scadam526/audio_amp_main_board/README.md

# audio_amp_main_board
Main board for a stereo 60W-per-channel amp. Includes four RCA analog L/R inputs, pre-amp input switching and volume control, main gain stage and output protection and muting.
