scadam526/audio_amp_main_board/(threads)

Thread 3 (2020-01-24):

Part placement

scadam526, 2020-01-24:
Place parts in their general location. Routing to be finalized once BOM review is complete.

scadam526, 2020-01-30:
Auto-route showed that 4-layer is much preferred. Created 4-layer board branch to try it out. 4-layer offers ability to route main audio and power traces as desired then easily auto-route the remainder around it. Still will not have +/-35V power planes. They power (dc and audio) will still be routed as 2mm traces and all layers will get GND fill planes.

Closed 2020-04-08.
