scadam526/audio_amp_main_board/doc/Printing Print Schematic.pdf

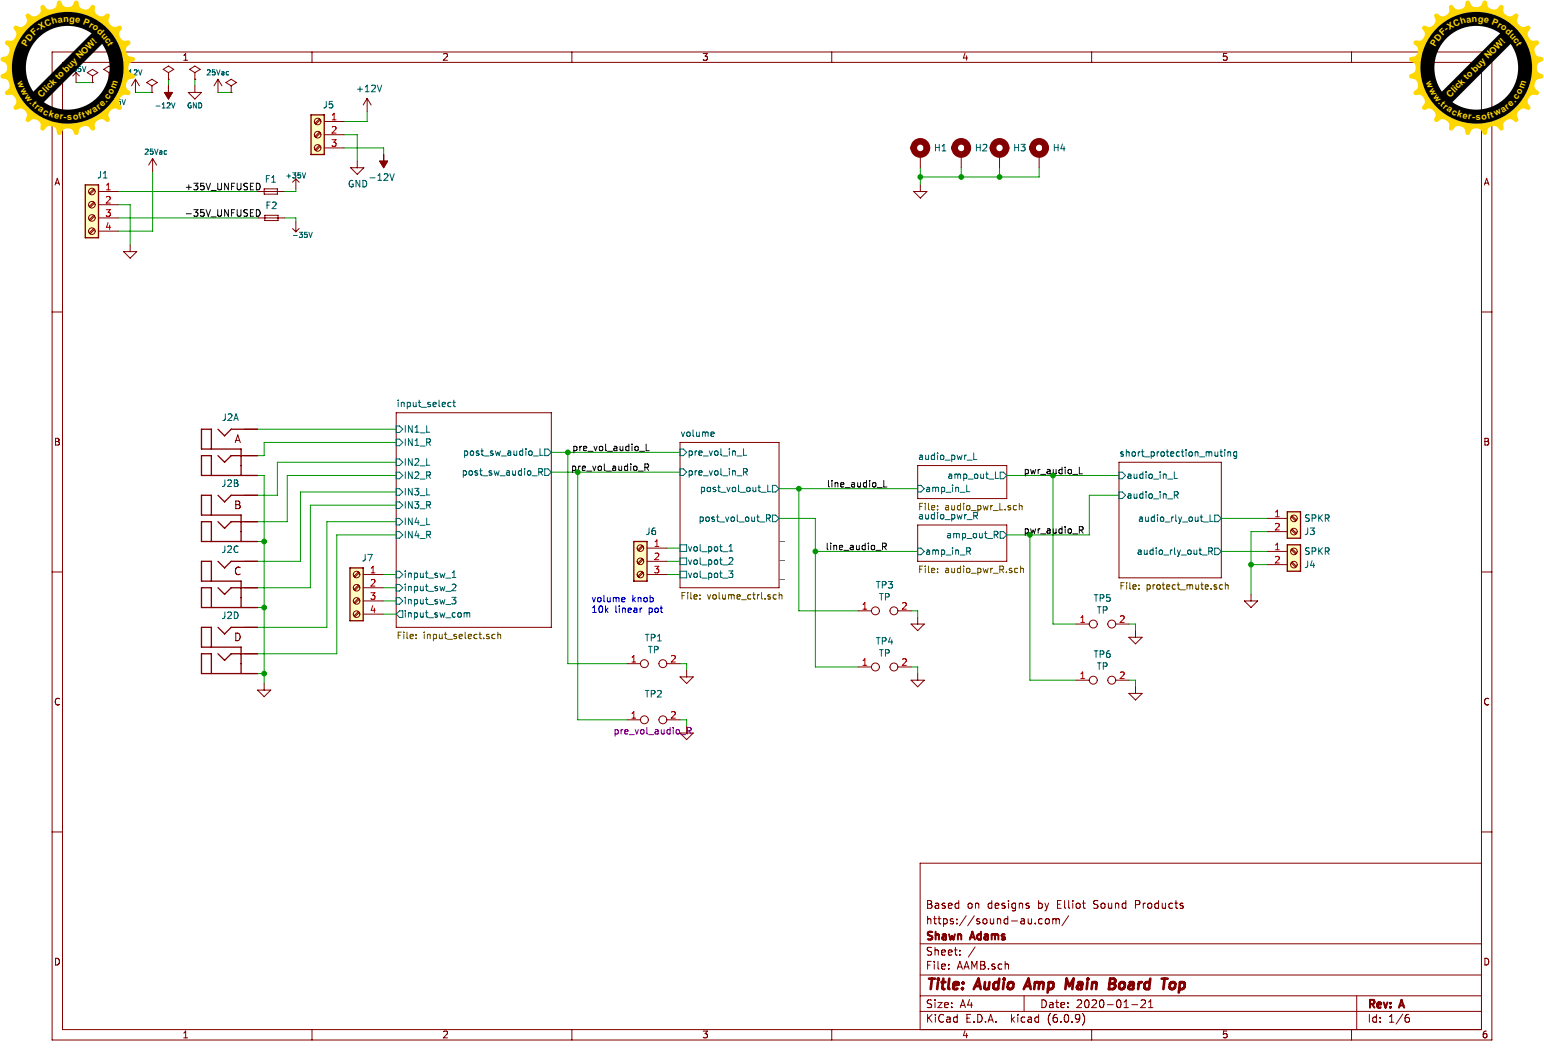
[picture p1: page 1]

PDF-XChange Product

Click to buy NOW!

www.tracker-software.com

www.tracker-software.com (http://www.tracker-software.com/buy-now)

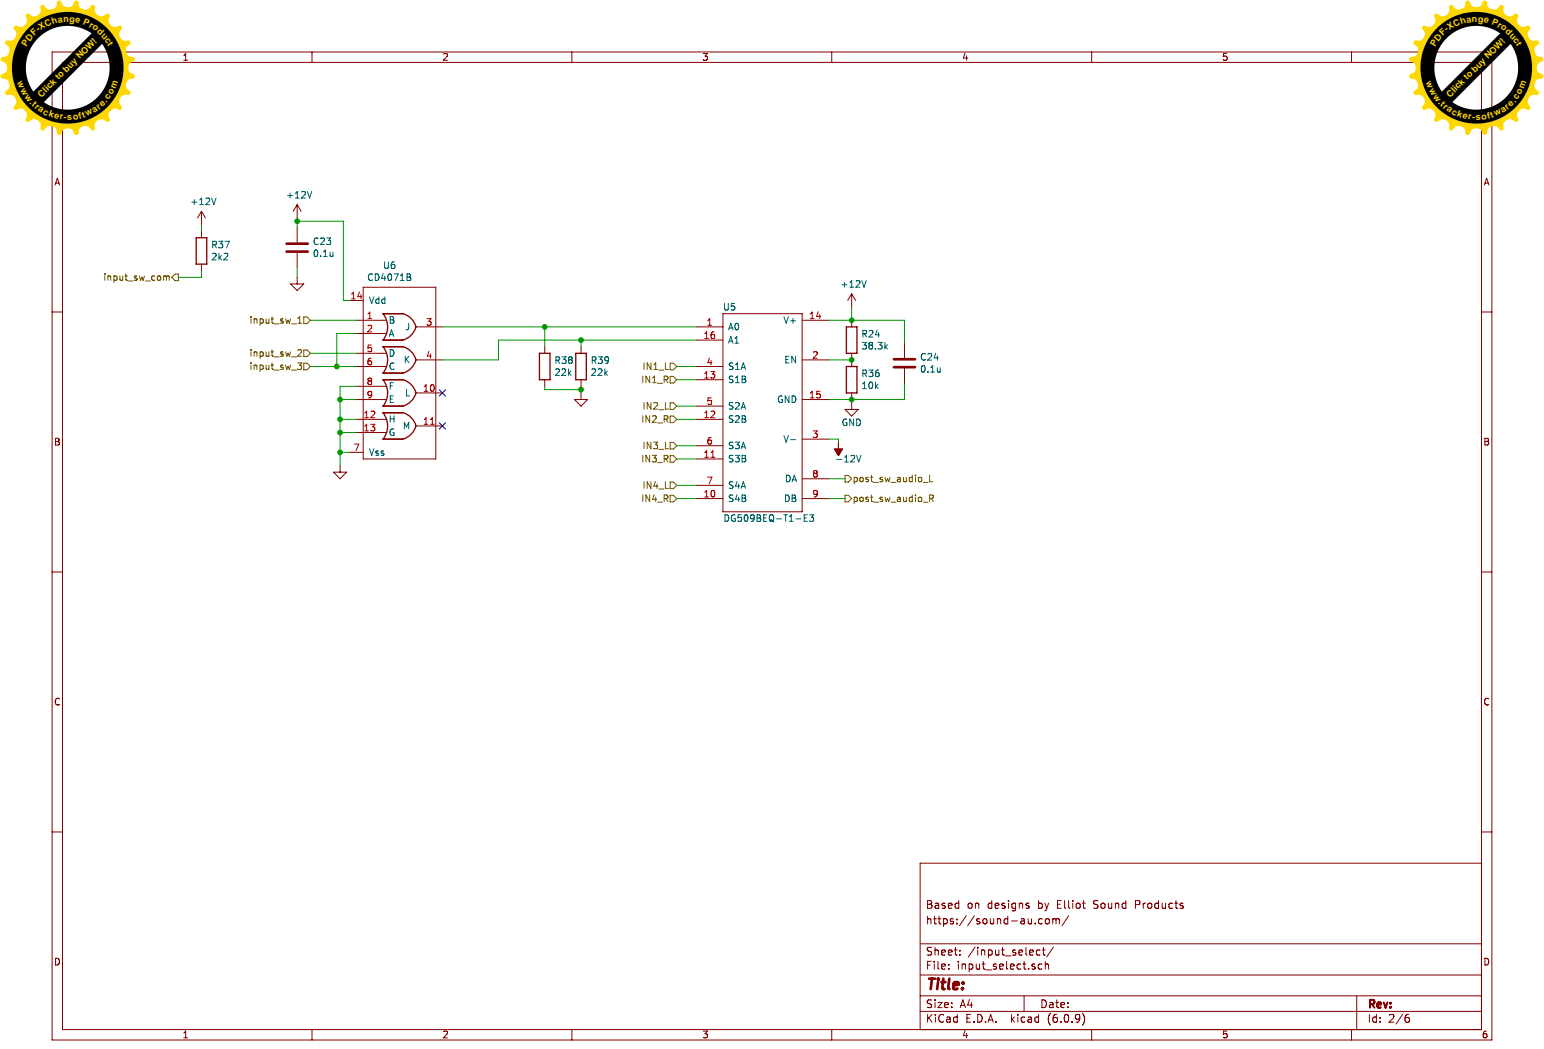
[picture p2: page 2]

Click to buy NOW!

www.tracker-software.com

www.tracker-software.com (http://www.tracker-software.com/buy-now)

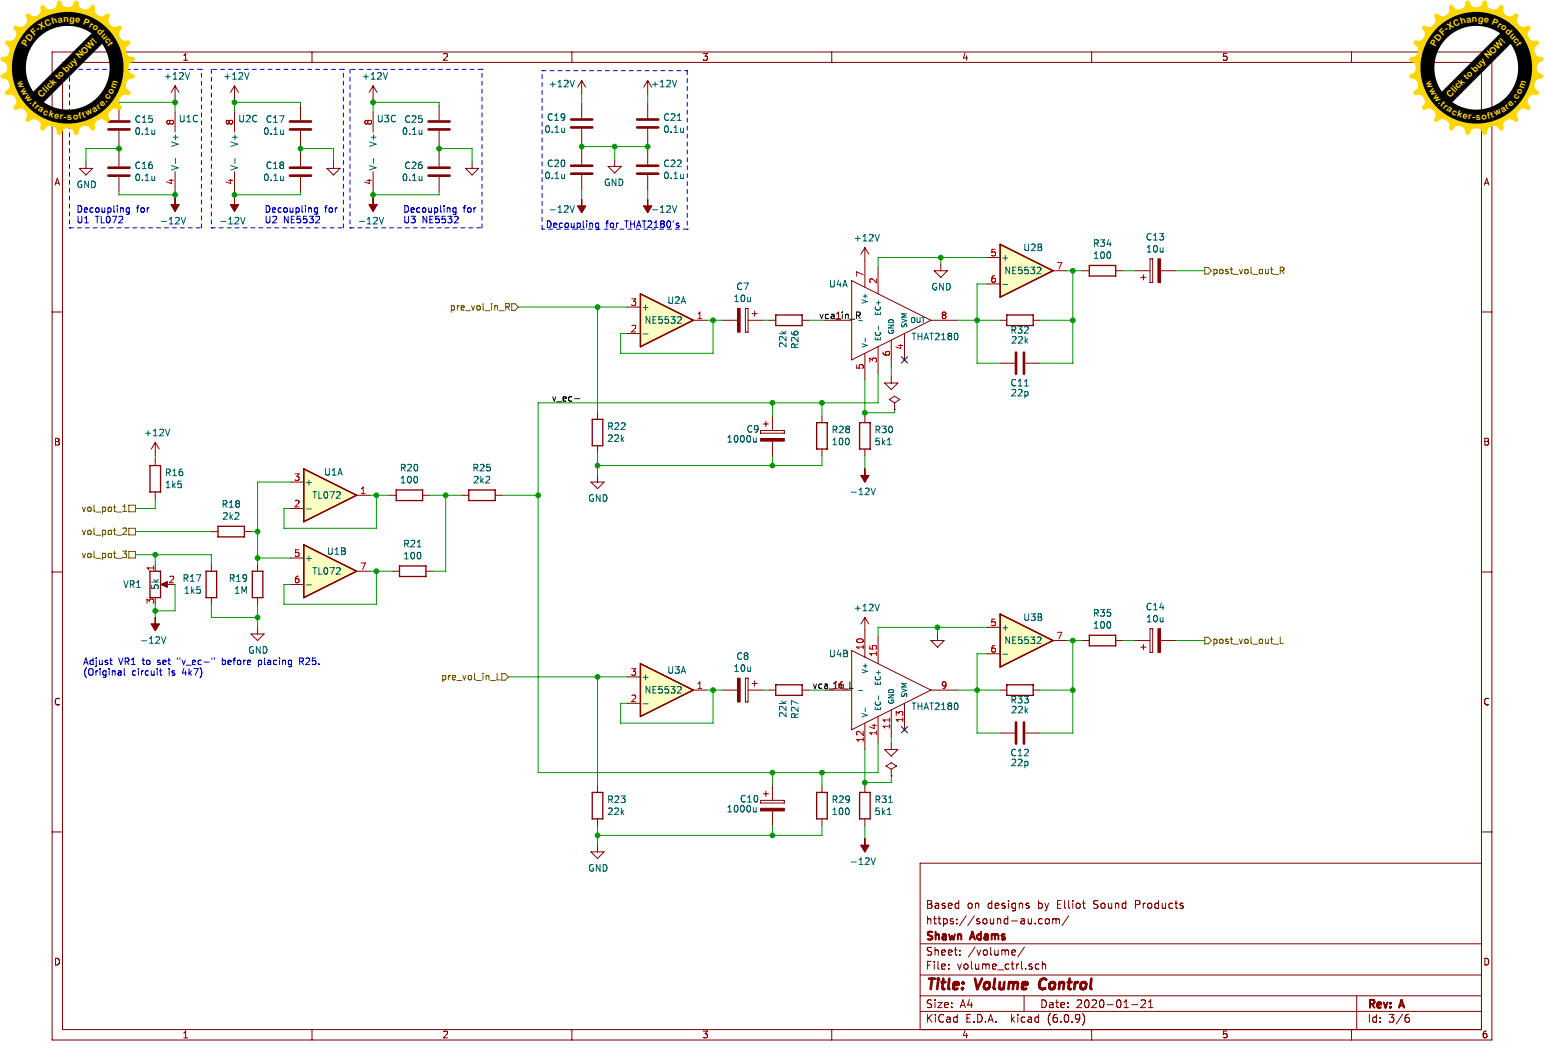
[picture p3: page 3]

Click to buy NOW!

www.tracker-software.com

www.tracker-software.com (http://www.tracker-software.com/buy-now)

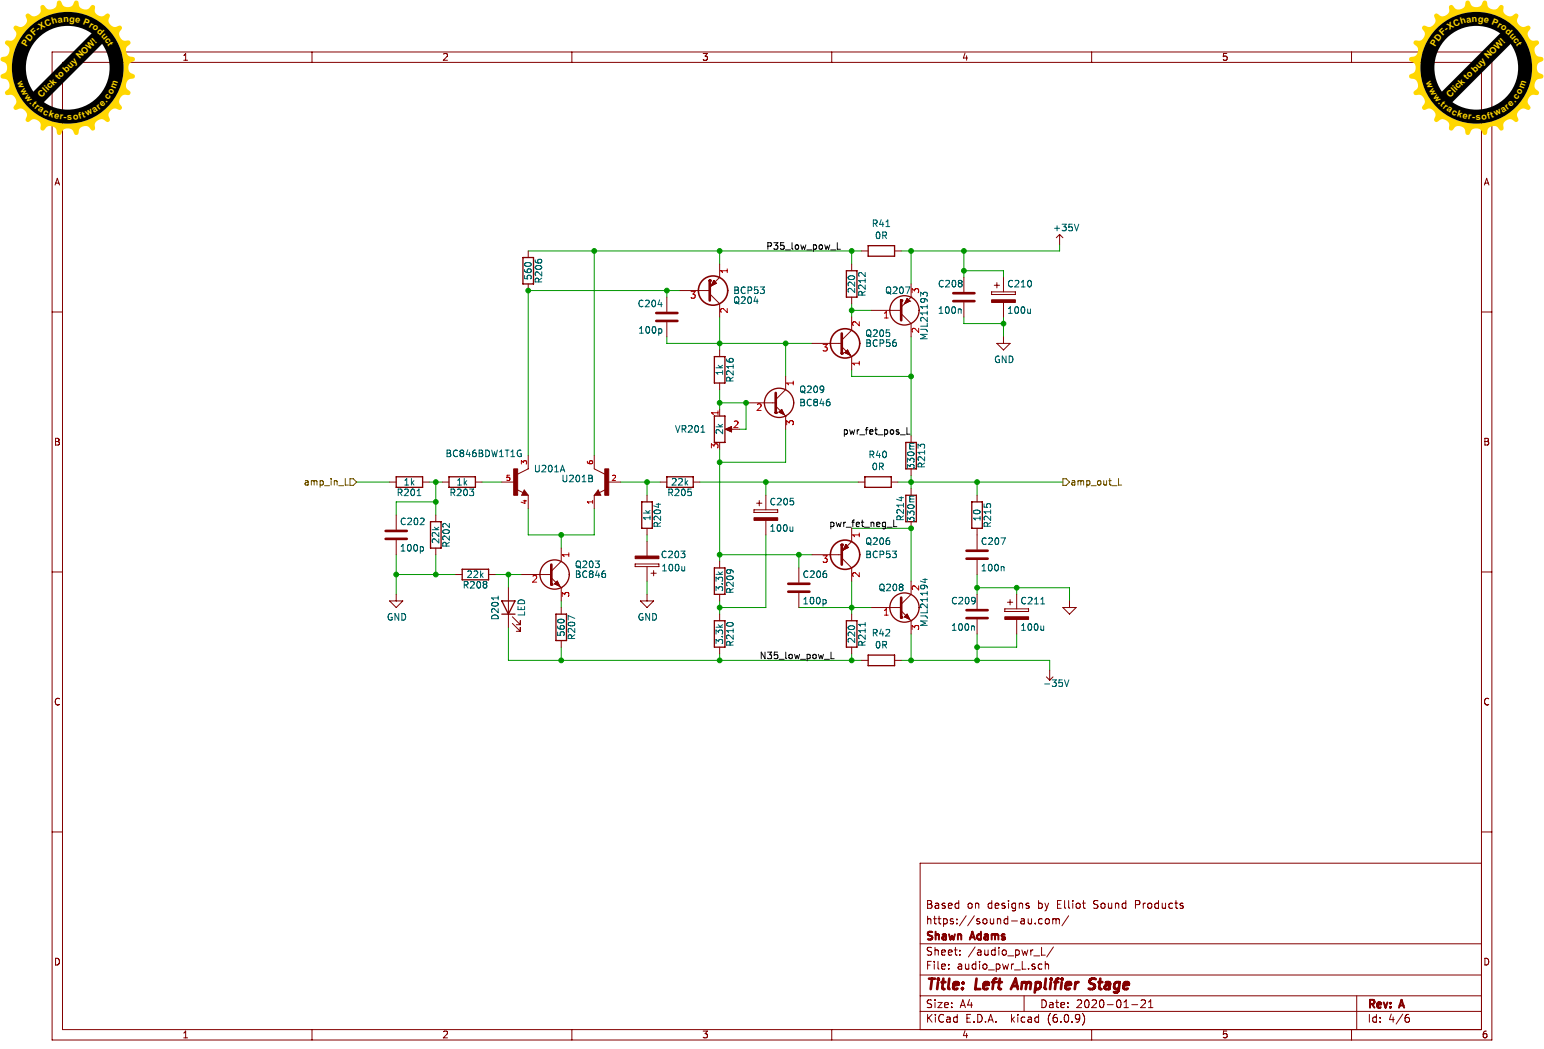
[picture p4: page 4]

Click to buy NOW!

www.tracker-software.com

www.tracker-software.com (http://www.tracker-software.com/buy-now)

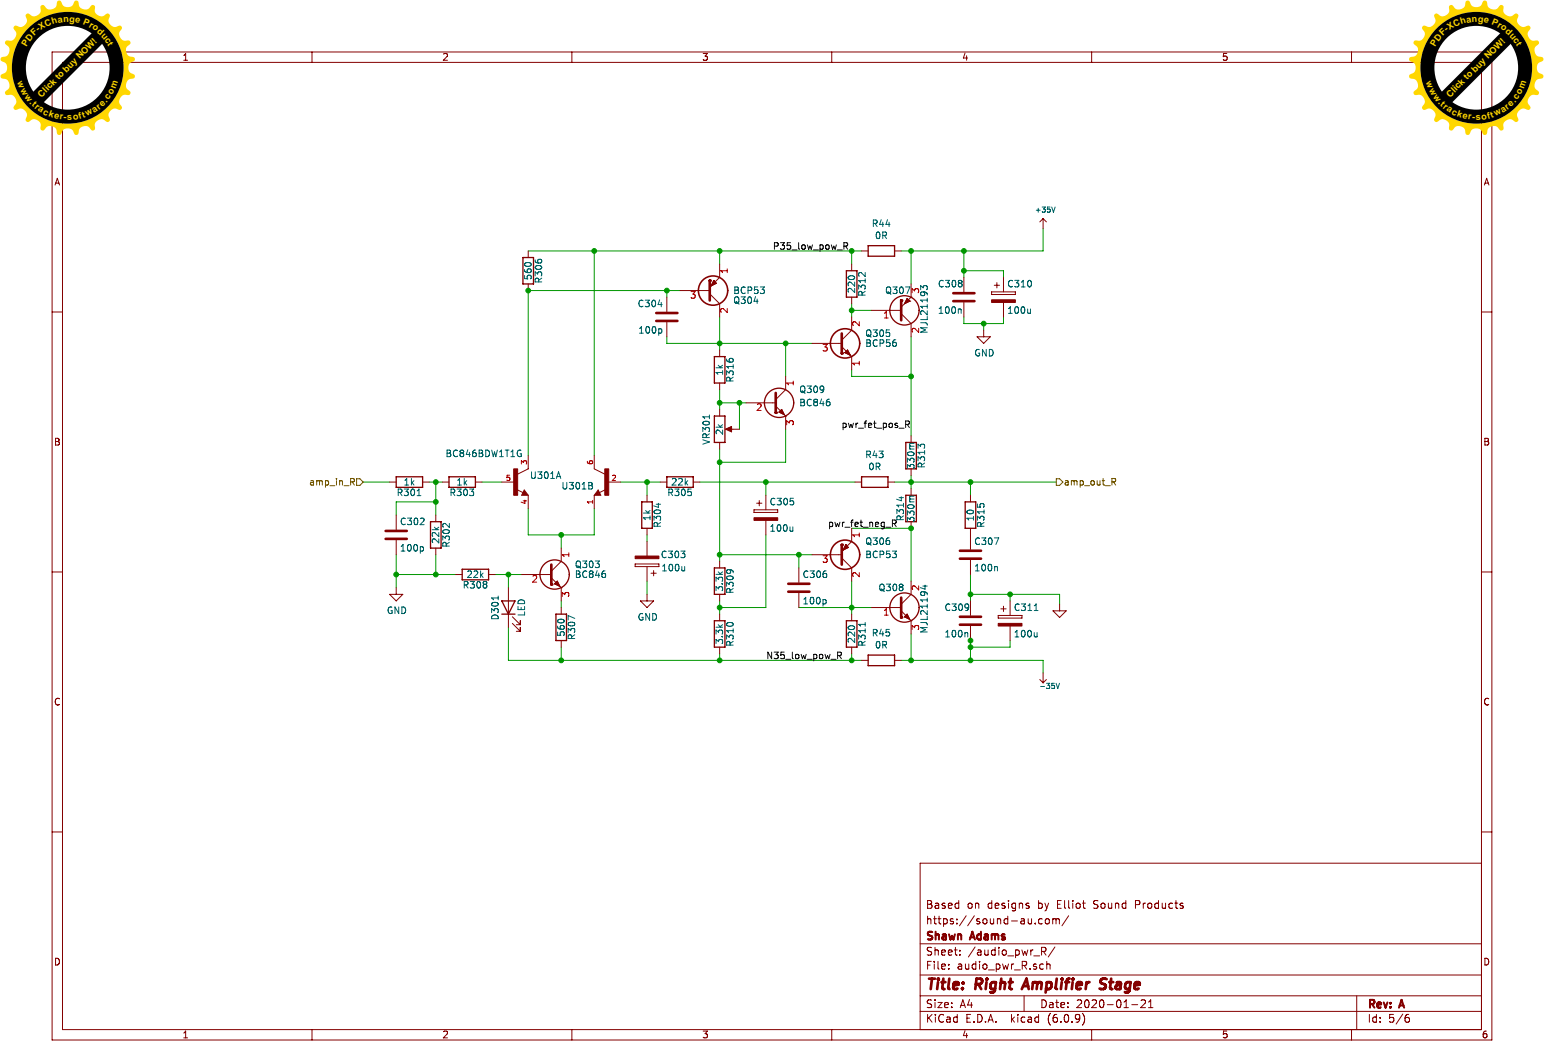
[picture p5: page 5]

Click to buy NOW!

www.tracker-software.com

www.tracker-software.com (http://www.tracker-software.com/buy-now)

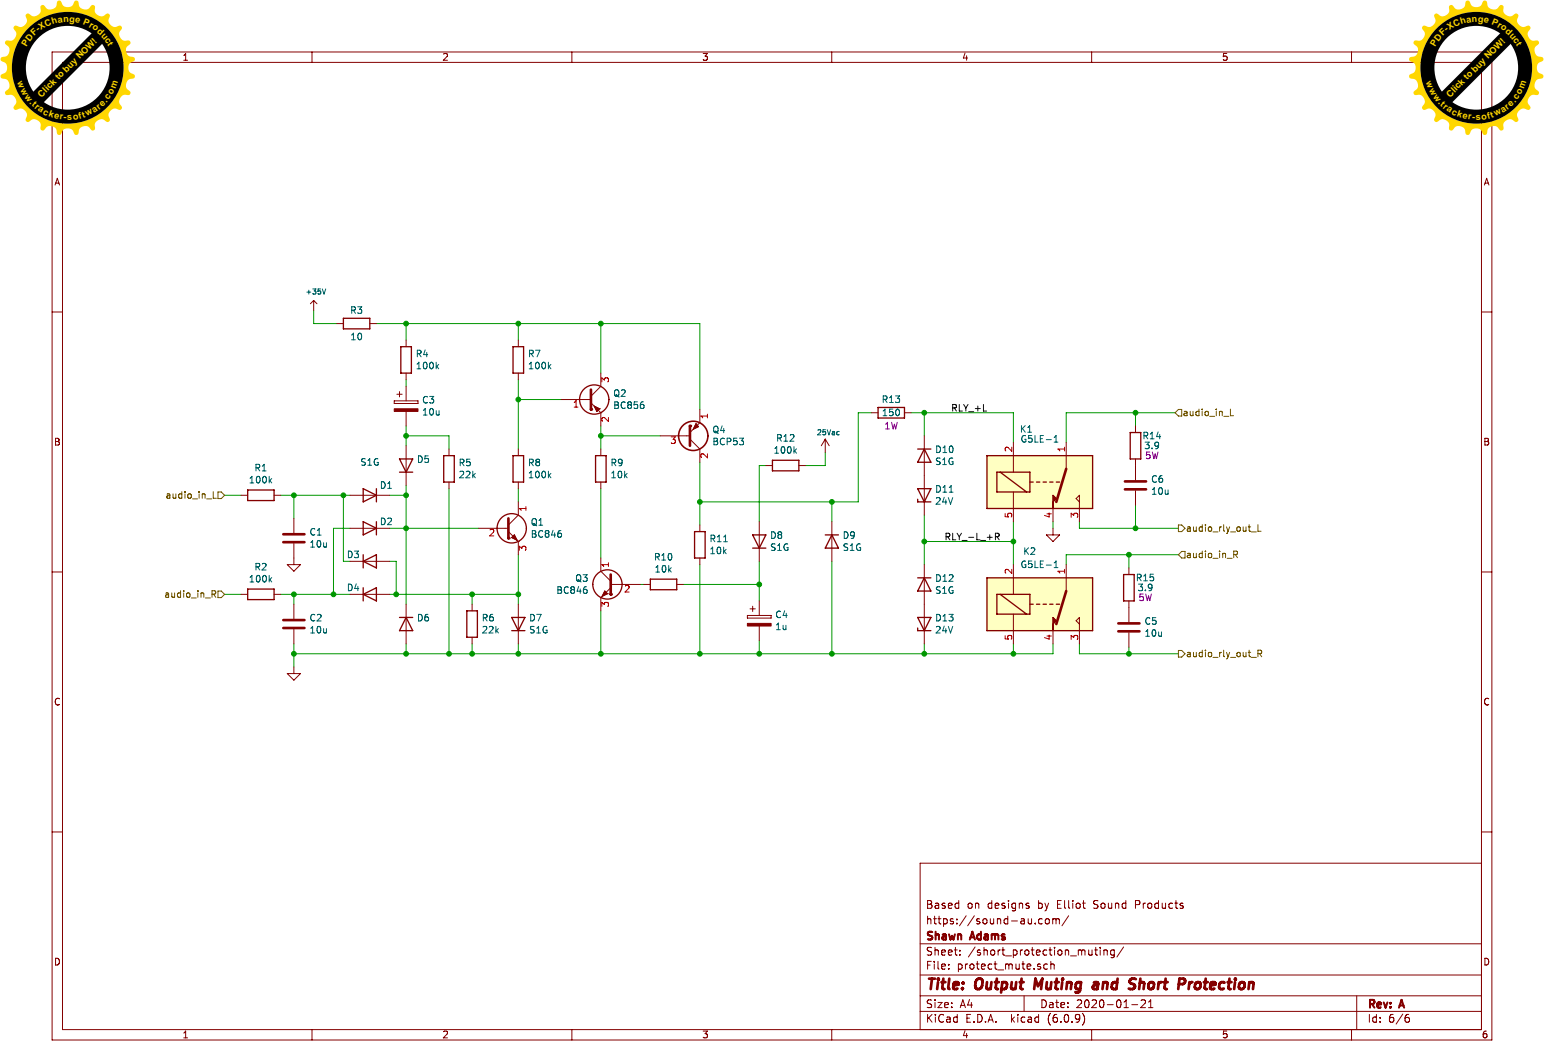
[picture p6: page 6]

Click to buy NOW!

www.tracker-software.com

www.tracker-software.com (http://www.tracker-software.com/buy-now)
