scadam526/audio_amp_main_board/AAMB.kicad_pcb

## KiCad design AAMB.kicad_pcb (2023-03-01)

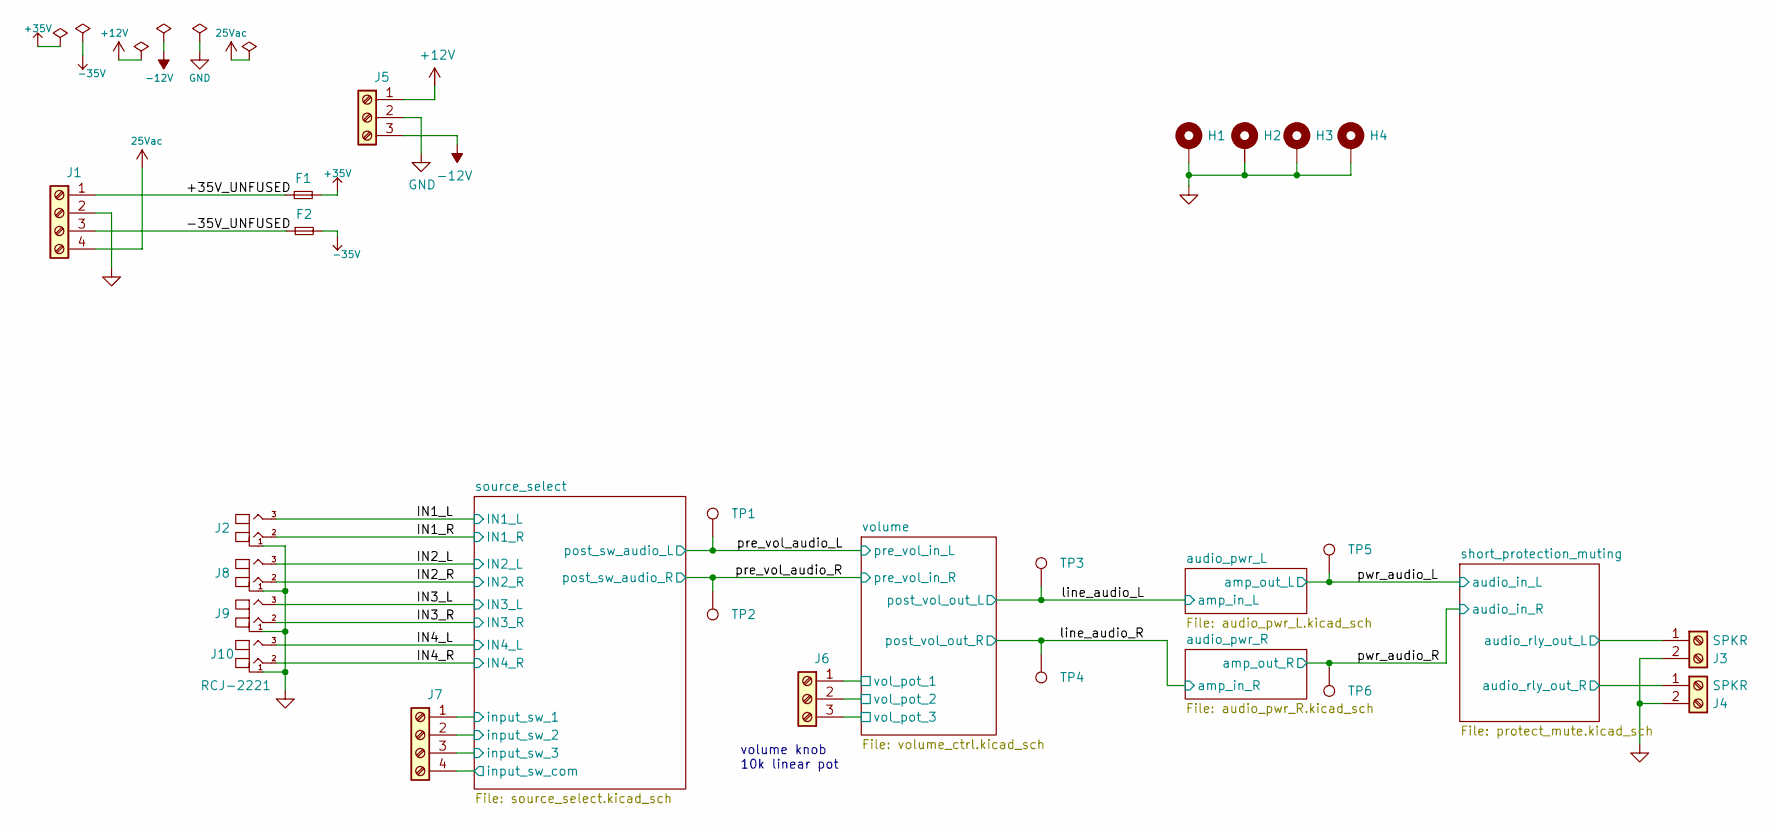
[picture p7: schematic AAMB.kicad_sch, Audio Amp Main Board Top]

Parts:
F1, F2: Fuse_Small; R_1206_3216Metric_Pad1.30x1.75mm_HandSolder; MPN C1F 3
H1, H2, H3, H4: MountingHole_Pad; MountingHole_3.2mm_M3_Pad
J1, J7: Screw_Terminal_01x04; TerminalBlock_Phoenix_MKDS-1,5-4_1x04_P5.00mm_Horizontal; MPN TB001-500-04BE
J2, J8, J9, J10: RCJ-2221
J3, J4: SPKR; TerminalBlock_Phoenix_MKDS-1,5-2_1x02_P5.00mm_Horizontal; MPN 1935161
J5, J6: Screw_Terminal_01x03; TerminalBlock_Phoenix_MKDS-1,5-3_1x03_P5.00mm_Horizontal; MPN 1935174
TP1, TP2, TP3, TP4, TP5, TP6: TestPoint; TestPoint_Keystone_5000-5004_Miniature

Connections:
25Vac: J1.4; also elsewhere on the board
+12V: J5.1; also elsewhere on the board
+35V: F1.2; also elsewhere on the board
-12V: J5.3; also elsewhere on the board
-35V: F2.2; also elsewhere on the board
/+35V_UNFUSED: F1.1, J1.1
/-35V_UNFUSED: F2.1, J1.3
/IN1_L: J2.3; also elsewhere on the board
/IN1_R: J2.2; also elsewhere on the board
/IN2_L: J8.3; also elsewhere on the board
/IN2_R: J8.2; also elsewhere on the board
/IN3_L: J9.3; also elsewhere on the board
/IN3_R: J9.2; also elsewhere on the board
/IN4_L: J10.3; also elsewhere on the board
/IN4_R: J10.2; also elsewhere on the board
/line_audio_L: TP3.1; also elsewhere on the board
/line_audio_R: TP4.1; also elsewhere on the board
/pre_vol_audio_L: TP1.1; also elsewhere on the board
/pre_vol_audio_R: TP2.1; also elsewhere on the board
/pwr_audio_L: TP5.1; also elsewhere on the board
/pwr_audio_R: TP6.1; also elsewhere on the board
/short_protection_muting/audio_rly_out_L: J3.1; also elsewhere on the board
/short_protection_muting/audio_rly_out_R: J4.1; also elsewhere on the board
/source_select/input_sw_1: J7.1; also elsewhere on the board
/source_select/input_sw_2: J7.2; also elsewhere on the board
/source_select/input_sw_3: J7.3; also elsewhere on the board
/source_select/input_sw_com: J7.4; also elsewhere on the board
/volume/vol_pot_1: J6.1; also elsewhere on the board
/volume/vol_pot_2: J6.2; also elsewhere on the board
/volume/vol_pot_3: J6.3; also elsewhere on the board
GND: H1.1, H2.1, H3.1, H4.1, J1.2, J2.1, J3.2, J4.2, J5.2, J8.1, J9.1, J10.1; also elsewhere on the board

Notes on the sheet:
volume knob 10k linear pot

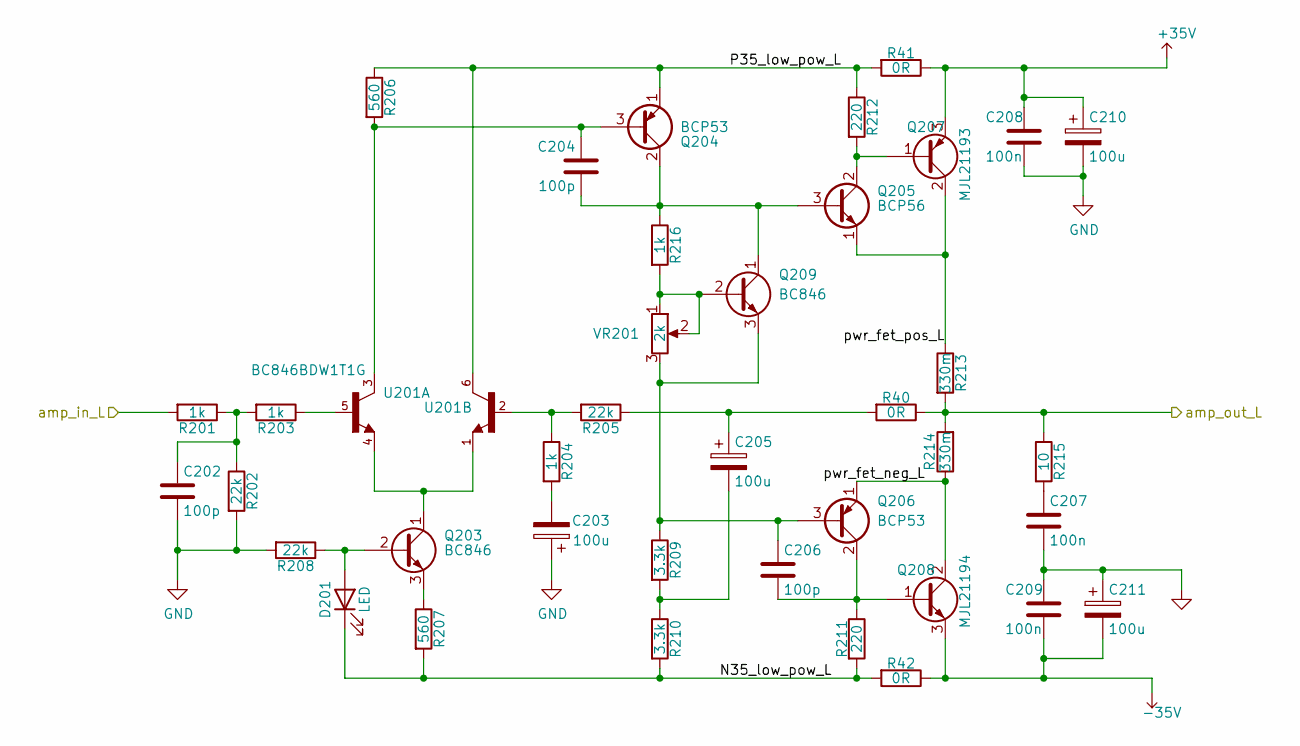
[picture p8: schematic audio_pwr_L.kicad_sch, Left Amplifier Stage]

Parts:
C202, C204, C206: 100p; C_0603_1608Metric_Pad1.08x0.95mm_HandSolder; MPN 885012006057
C203: 100u; C_Elec_5x5.4; MPN 865080142007
C205: 100u; C_Elec_6.3x7.7; MPN 865080545012
C207, C208, C209: 100n; C_Rect_L7.2mm_W4.5mm_P5.00mm_FKS2_FKP2_MKS2_MKP2; MPN R82EC3100AA70K
C210, C211: 100u; CP_Elec_10x10.5; MPN UUX1J101MNL1GS
D201: LED; LED_0603_1608Metric_Pad1.05x0.95mm_HandSolder; MPN SML-D12U1WT86
Q203, Q209: BC846; TO-92_Molded_Narrow; MPN BC846BLT1G
Q204, Q206: BCP53; TO-126_Vertical; MPN SBCP53-10T1G
Q205: BCP56; TO-126_Vertical; MPN SBCP56-16T3G
Q207: MJL21193; TO-264-3_Vertical; MPN MJL21193G
Q208: MJL21194; TO-264-3_Vertical; MPN MJL21194G
R40, R41, R42: 0R; R_2010_5025Metric; MPN RMCF1210ZT0R00
R201, R203, R204, R216: 1k; R_0201_0603Metric_Pad0.64x0.40mm_HandSolder; MPN RCS06031K00FKEA
R202, R205, R208: 22k; R_0201_0603Metric_Pad0.64x0.40mm_HandSolder; MPN CRGCQ0603F22K
R206, R207: 560; R_0201_0603Metric_Pad0.64x0.40mm_HandSolder; MPN CRGCQ0603F560R
R209, R210: 3.3k; R_0201_0603Metric_Pad0.64x0.40mm_HandSolder; MPN CRCW06033K30FKEA
R211, R212: 220; R_0201_0603Metric_Pad0.64x0.40mm_HandSolder; MPN ERJ-PA3F2200V
R213, R214: 330m; R_Radial_Power_L13.0mm_W9.0mm_P5.00mm; MPN SQMW5R33J
R215: 10; R_0201_0603Metric_Pad0.64x0.40mm_HandSolder; MPN ERJ-PA3F10R0V
U201: BC846BDW1T1G; SOT65P210X110-6N; MPN BC846BDW1T1G
VR201: 2k; Potentiometer_Bourns_3296W_Vertical; MPN 3296W-1-202LF

Connections:
+35V: C208.1, C210.1, Q207.3 (E), R41.1; also elsewhere on the board
-35V: C209.2, C211.2, Q208.3 (E), R42.1; also elsewhere on the board
/audio_pwr_L/N35_low_pow_L: D201.1 (K), R42.2, R207.2, R210.2, R211.2
/audio_pwr_L/P35_low_pow_L: Q204.1 (E), R41.2, R206.1, R212.1, U201.6 (COLLECTOR_2)
/audio_pwr_L/pwr_fet_neg_L: Q206.1 (E), Q208.2 (C), R214.1
/audio_pwr_L/pwr_fet_pos_L: Q205.1 (E), Q207.2 (C), R213.1
/line_audio_L: R201.2; also elsewhere on the board
/pwr_audio_L: R40.1, R213.2, R214.2, R215.1; also elsewhere on the board
GND: C202.2, C203.1, C207.2, C208.2, C209.1, C210.2, C211.1, R202.2, R208.2; also elsewhere on the board
unnamed: C202.1, R201.1, R202.1, R203.2
unnamed: C203.2, R204.2
unnamed: C204.1, Q204.3 (B), R206.2, U201.3 (COLLECTOR_1)
unnamed: C204.2, Q204.2 (C), Q205.3 (B), Q209.1 (C), R216.1
unnamed: C205.1, R40.2, R205.1
unnamed: C205.2, R209.2, R210.1
unnamed: C206.1, Q206.3 (B), Q209.3 (E), R209.1, VR201.3
unnamed: C206.2, Q206.2 (C), Q208.1 (B), R211.1
unnamed: C207.1, R215.2
unnamed: D201.2 (A), Q203.2 (B), R208.1
unnamed: Q203.1 (C), U201.1 (EMITTER_2), U201.4 (EMITTER_1)
unnamed: Q203.3 (E), R207.1
unnamed: Q205.2 (C), Q207.1 (B), R212.2
unnamed: Q209.2 (B), R216.2, VR201.1, VR201.2
unnamed: R203.1, U201.5 (BASE_1)
unnamed: R204.1, R205.2, U201.2 (BASE_2)

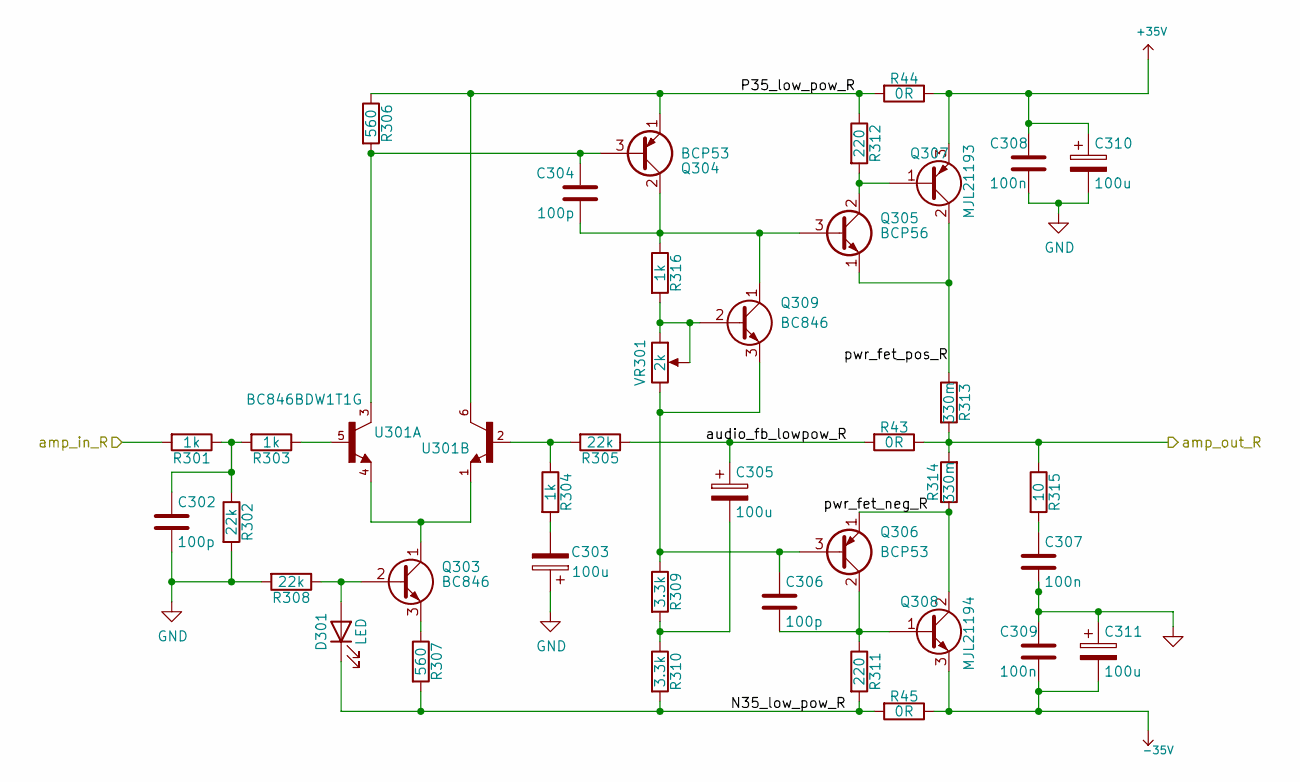
[picture p9: schematic audio_pwr_R.kicad_sch, Right Amplifier Stage]

Parts:
C302, C304, C306: 100p; C_0603_1608Metric_Pad1.08x0.95mm_HandSolder; MPN 885012006057
C303: 100u; C_Elec_5x5.4; MPN 865080142007
C305: 100u; C_Elec_6.3x7.7; MPN 865080545012
C307, C308, C309: 100n; C_Rect_L7.2mm_W4.5mm_P5.00mm_FKS2_FKP2_MKS2_MKP2; MPN R82EC3100AA70K
C310, C311: 100u; CP_Elec_10x10.5; MPN UUX1J101MNL1GS
D301: LED; LED_0603_1608Metric_Pad1.05x0.95mm_HandSolder; MPN SML-D12U1WT86
Q303, Q309: BC846; TO-92_Molded_Narrow; MPN BC846BLT1G
Q304, Q306: BCP53; TO-126_Vertical; MPN SBCP53-10T1G
Q305: BCP56; TO-126_Vertical; MPN SBCP56-16T3G
Q307: MJL21193; TO-264-3_Vertical; MPN MJL21193G
Q308: MJL21194; TO-264-3_Vertical; MPN MJL21194G
R43, R44, R45: 0R; R_2010_5025Metric; MPN RMCF1210ZT0R00
R301, R303, R304, R316: 1k; R_0201_0603Metric_Pad0.64x0.40mm_HandSolder; MPN RCS06031K00FKEA
R302, R305, R308: 22k; R_0201_0603Metric_Pad0.64x0.40mm_HandSolder; MPN CRGCQ0603F22K
R306, R307: 560; R_0201_0603Metric_Pad0.64x0.40mm_HandSolder; MPN CRGCQ0603F560R
R309, R310: 3.3k; R_0201_0603Metric_Pad0.64x0.40mm_HandSolder; MPN CRCW06033K30FKEA
R311, R312: 220; R_0201_0603Metric_Pad0.64x0.40mm_HandSolder; MPN ERJ-PA3F2200V
R313, R314: 330m; R_Radial_Power_L13.0mm_W9.0mm_P5.00mm; MPN SQMW5R33J
R315: 10; R_0201_0603Metric_Pad0.64x0.40mm_HandSolder; MPN ERJ-PA3F10R0V
U301: BC846BDW1T1G; SOT65P210X110-6N; MPN BC846BDW1T1G
VR301: 2k; Potentiometer_Bourns_3296W_Vertical; MPN 3296W-1-202LF

Connections:
+35V: C308.1, C310.1, Q307.3 (E), R44.1; also elsewhere on the board
-35V: C309.2, C311.2, Q308.3 (E), R45.1; also elsewhere on the board
/audio_pwr_R/N35_low_pow_R: D301.1 (K), R45.2, R307.2, R310.2, R311.2
/audio_pwr_R/P35_low_pow_R: Q304.1 (E), R44.2, R306.1, R312.1, U301.6 (COLLECTOR_2)
/audio_pwr_R/pwr_fet_neg_R: Q306.1 (E), Q308.2 (C), R314.1
/audio_pwr_R/pwr_fet_pos_R: Q305.1 (E), Q307.2 (C), R313.1
/line_audio_R: R301.2; also elsewhere on the board
/pwr_audio_R: R43.1, R313.2, R314.2, R315.1; also elsewhere on the board
GND: C302.2, C303.1, C307.2, C308.2, C309.1, C310.2, C311.1, R302.2, R308.2; also elsewhere on the board
unnamed: C302.1, R301.1, R302.1, R303.2
unnamed: C303.2, R304.2
unnamed: C304.1, Q304.3 (B), R306.2, U301.3 (COLLECTOR_1)
unnamed: C304.2, Q304.2 (C), Q305.3 (B), Q309.1 (C), R316.1
unnamed: C305.1, R43.2, R305.1
unnamed: C305.2, R309.2, R310.1
unnamed: C306.1, Q306.3 (B), Q309.3 (E), R309.1, VR301.3
unnamed: C306.2, Q306.2 (C), Q308.1 (B), R311.1
unnamed: C307.1, R315.2
unnamed: D301.2 (A), Q303.2 (B), R308.1
unnamed: Q303.1 (C), U301.1 (EMITTER_2), U301.4 (EMITTER_1)
unnamed: Q303.3 (E), R307.1
unnamed: Q305.2 (C), Q307.1 (B), R312.2
unnamed: Q309.2 (B), R316.2, VR301.1, VR301.2
unnamed: R303.1, U301.5 (BASE_1)
unnamed: R304.1, R305.2, U301.2 (BASE_2)

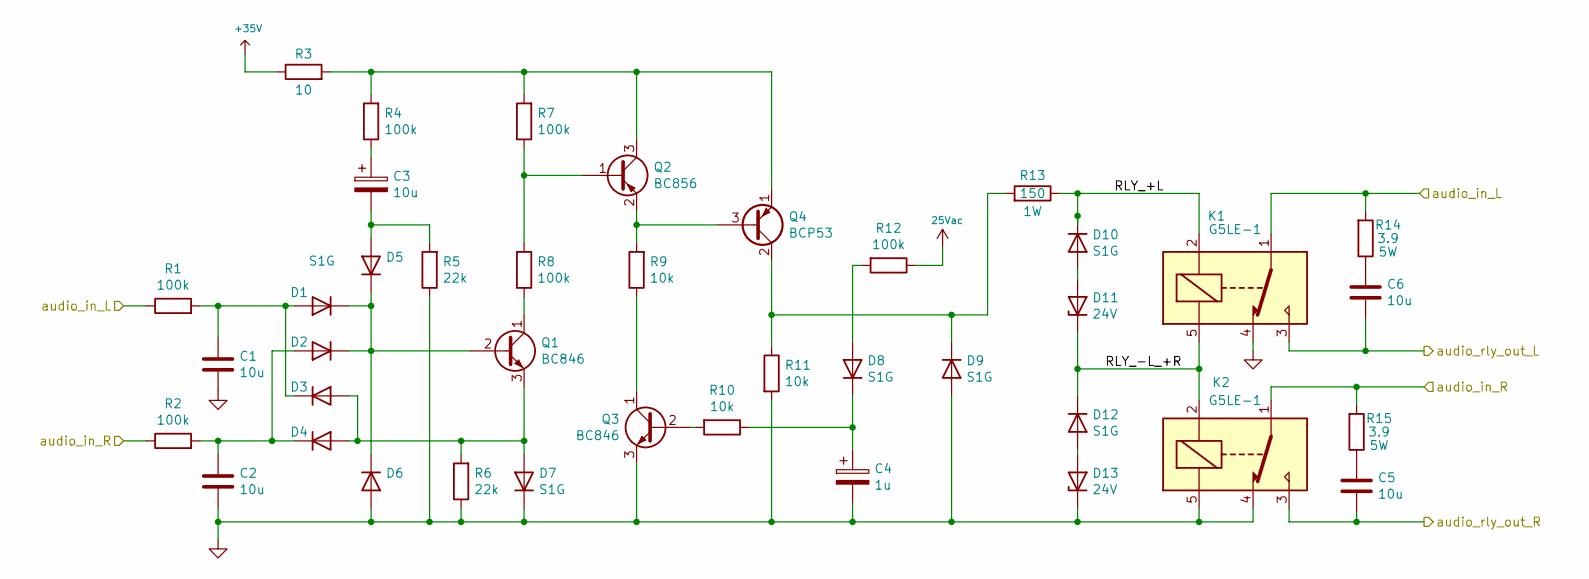
[picture p10: schematic protect_mute.kicad_sch, Output Muting and Short Protection]

Parts:
C1, C2, C5, C6: 10u; C_1206_3216Metric; MPN GRT31CR61H106KE01L
C3: 10u; CP_Elec_5x3; MPN 865080642006
C4: 1u; CP_Elec_4x5.4; MPN 865060640001
D1, D2, D3, D4, D5, D6, D7, D8, D9, D10, D12: S1G; D_DO-41_SOD81_P10.16mm_Horizontal; MPN S1G
D11, D13: 24V; D_SMA; MPN 1SMA5934BT3G
K1, K2: G5LE-1; Relay_SPDT_Omron-G5LE-1; MPN G5LE-1-VDDC12
Q1, Q3: BC846; TO-92_Inline; MPN BC846BLT1G
Q2: BC856; SOT-23; MPN BC856BLT3G
Q4: BCP53; TO-126-3_Vertical; MPN SBCP53-10T1G
R1, R2, R4, R7, R8, R12: 100k; R_0201_0603Metric_Pad0.64x0.40mm_HandSolder; MPN MCT06030C1003FP500
R3: 10; R_0201_0603Metric_Pad0.64x0.40mm_HandSolder; MPN ERJ-PA3F10R0V
R5, R6: 22k; R_0201_0603Metric_Pad0.64x0.40mm_HandSolder; MPN CRGCQ0603F22K
R9, R10, R11: 10k; R_0201_0603Metric_Pad0.64x0.40mm_HandSolder; MPN CRGCQ0603F10K
R13: 150; R_2512_6332Metric; MPN CRCW2512150RFKEG
R14, R15: 3.9; R_Axial_DIN0918_L18.0mm_D9.0mm_P7.62mm_Vertical; MPN SQPW53R9J

Connections:
25Vac: R12.1; also elsewhere on the board
+35V: R3.1; also elsewhere on the board
/pwr_audio_L: K1.1, R1.1, R14.2; also elsewhere on the board
/pwr_audio_R: K2.1, R2.1, R15.2; also elsewhere on the board
/short_protection_muting/RLY_+L: D10.1 (K), K1.2, R13.1
/short_protection_muting/RLY_-L_+R: D11.1 (K), D12.1 (K), K1.5, K2.2
/short_protection_muting/audio_rly_out_L: C6.2, K1.3; also elsewhere on the board
/short_protection_muting/audio_rly_out_R: C5.2, K2.3; also elsewhere on the board
GND: C1.2, C2.2, C4.2, D6.2 (A), D7.1 (K), D9.2 (A), D13.1 (K), K1.4, K2.4, K2.5, Q3.3 (E), R5.1, R6.1, R11.2; also elsewhere on the board
unnamed: C1.1, D1.2 (A), D3.1 (K), R1.2
unnamed: C2.1, D2.2 (A), D4.1 (K), R2.2
unnamed: C3.1, R4.1
unnamed: C3.2, D5.2 (A), R5.2
unnamed: C4.1, D8.1 (K), R10.1
unnamed: C5.1, R15.1
unnamed: C6.1, R14.1
unnamed: D1.1 (K), D2.1 (K), D5.1 (K), D6.1 (K), Q1.2 (B)
unnamed: D3.2 (A), D4.2 (A), D7.2 (A), Q1.3 (E), R6.2
unnamed: D8.2 (A), R12.2
unnamed: D9.1 (K), Q4.2 (C), R11.1, R13.2
unnamed: D10.2 (A), D11.2 (A)
unnamed: D12.2 (A), D13.2 (A)
unnamed: Q1.1 (C), R8.1
unnamed: Q2.1 (B), R7.1, R8.2
unnamed: Q2.2 (E), Q4.3 (B), R9.2
unnamed: Q2.3 (C), Q4.1 (E), R3.2, R4.2, R7.2
unnamed: Q3.1 (C), R9.1
unnamed: Q3.2 (B), R10.2

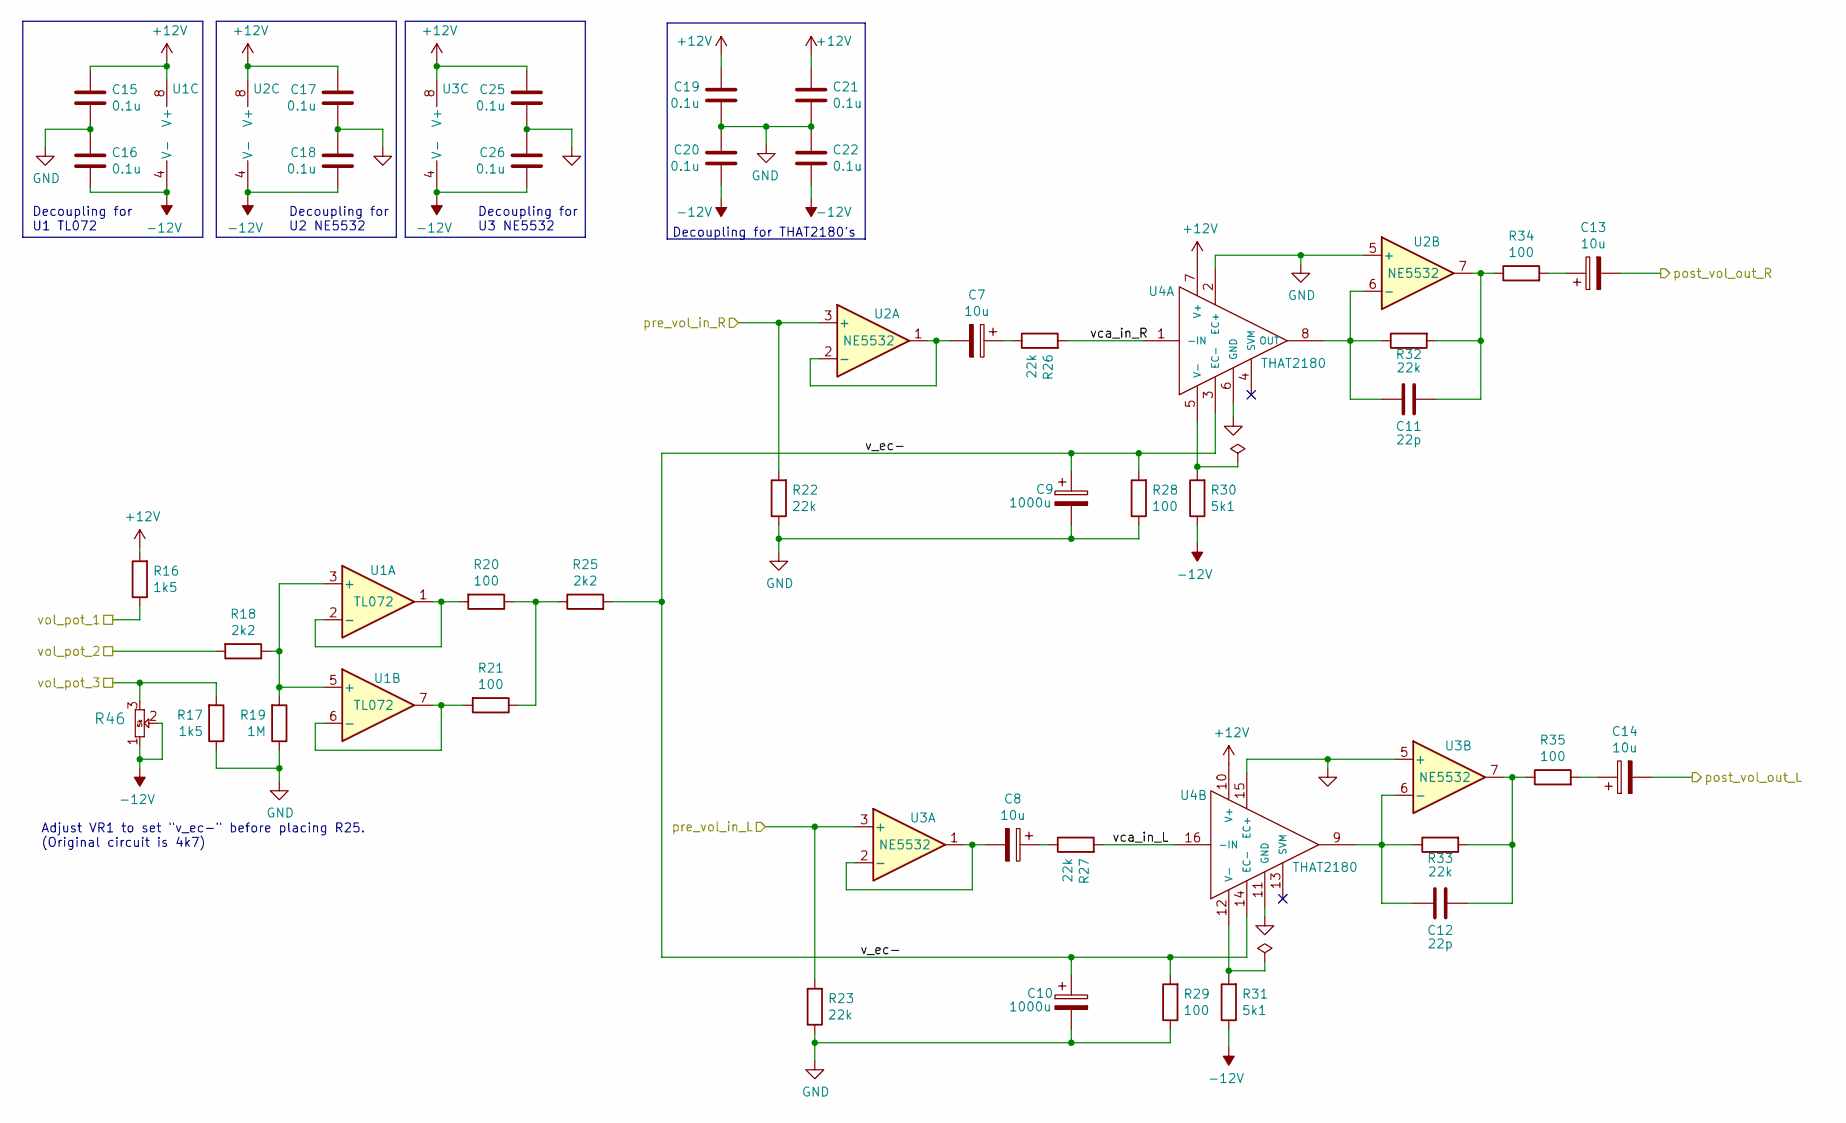
[picture p11: schematic volume_ctrl.kicad_sch, Volume Control]

Parts:
C7, C8, C13, C14: 10u; CP_Elec_5x3; MPN 865080642006
C9, C10: 1000u; C_Elec_10x10.2; MPN EEV-FK1E102Q
C11, C12: 22p; C_0603_1608Metric_Pad1.08x0.95mm_HandSolder; MPN 885012006053
C15, C16, C17, C18, C19, C20, C21, C22, C25, C26: 0.1u; C_0603_1608Metric_Pad1.08x0.95mm_HandSolder; MPN C0603C104Z3VACTU
R16, R17: 1k5; R_0201_0603Metric_Pad0.64x0.40mm_HandSolder; MPN ERJ-3EKF1501V
R18, R25: 2k2; R_0201_0603Metric_Pad0.64x0.40mm_HandSolder; MPN CRGCQ0603F2K2
R19: 1M; R_0201_0603Metric_Pad0.64x0.40mm_HandSolder; MPN ERJ-3EKF1004V
R20, R21, R28, R29, R34, R35: 100; R_0201_0603Metric_Pad0.64x0.40mm_HandSolder; MPN RCS0603100RFKEA
R22, R23, R26, R27, R32, R33: 22k; R_0201_0603Metric_Pad0.64x0.40mm_HandSolder; MPN CRGCQ0603F22K
R30, R31: 5k1; R_0201_0603Metric_Pad0.64x0.40mm_HandSolder; MPN ERJ-PA3F5101V
R46: 3203X502P; 3203X502P_TEC
U1: TL072; SOIC-8_3.9x4.9mm_P1.27mm; MPN TL072CDT
U2, U3: NE5532; SOIC-8_3.9x4.9mm_P1.27mm; MPN NE5532DR
U4: THAT2180; DIP-16_W7.62mm_SMDSocket_SmallPads; MPN 214-99-316-01-670800

Connections:
+12V: C15.1, C17.1, C19.1, C21.1, C25.1, R16.2, U1.8 (V+), U2.8 (V+), U3.8 (V+), U4.7 (V+), U4.10 (V+); also elsewhere on the board
-12V: C16.2, C18.2, C20.2, C22.2, C26.2, R30.1, R31.1, R46.1, R46.2, U1.4 (V-), U2.4 (V-), U3.4 (V-); also elsewhere on the board
/line_audio_L: C14.2; also elsewhere on the board
/line_audio_R: C13.2; also elsewhere on the board
/pre_vol_audio_L: R23.2, U3.3 (+); also elsewhere on the board
/pre_vol_audio_R: R22.2, U2.3 (+); also elsewhere on the board
/volume/v_ec-: C9.1, C10.1, R25.2, R28.2, R29.2, U4.3 (EC-), U4.14 (EC-)
/volume/vca_in_L: R27.2, U4.16 (-IN)
/volume/vca_in_R: R26.2, U4.1 (-IN)
/volume/vol_pot_1: R16.1; also elsewhere on the board
/volume/vol_pot_2: R18.2; also elsewhere on the board
/volume/vol_pot_3: R17.2, R46.3; also elsewhere on the board
GND: C9.2, C10.2, C15.2, C16.1, C17.2, C18.1, C19.2, C20.1, C21.2, C22.1, C25.2, C26.1, R17.1, R19.1, R22.1, R23.1, R28.1, R29.1, U2.5 (+), U3.5 (+), U4.2 (EC+), U4.6 (GND), U4.11 (GND), U4.15 (EC+); also elsewhere on the board
unnamed: C7.1, R26.1
unnamed: C7.2, U2.1, U2.2 (-)
unnamed: C8.1, R27.1
unnamed: C8.2, U3.1, U3.2 (-)
unnamed: C11.1, R32.2, R34.1, U2.7
unnamed: C11.2, R32.1, U2.6 (-), U4.8 (OUT)
unnamed: C12.1, R33.2, R35.1, U3.7
unnamed: C12.2, R33.1, U3.6 (-), U4.9
unnamed: C13.1, R34.2
unnamed: C14.1, R35.2
unnamed: R18.1, R19.2, U1.3 (+), U1.5 (+)
unnamed: R20.1, R21.1, R25.1
unnamed: R20.2, U1.1, U1.2 (-)
unnamed: R21.2, U1.6 (-), U1.7
unnamed: R30.2, U4.5 (V-)
unnamed: R31.2, U4.12 (V-)

Notes on the sheet:
Adjust VR1 to set "v_ec-" before placing R25. (Original circuit is 4k7)
Decoupling for U1 TL072
Decoupling for U2 NE5532
Decoupling for U3 NE5532
Decoupling for THAT2180's

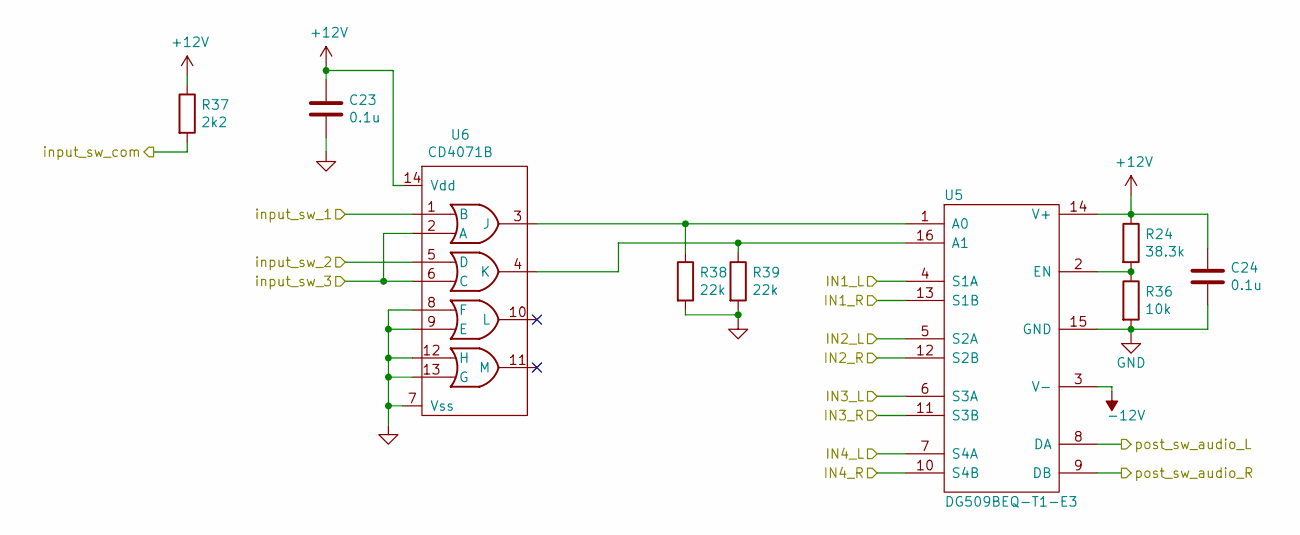
[picture p12: schematic source_select.kicad_sch]

Parts:
C23, C24: 0.1u; C_0603_1608Metric_Pad1.08x0.95mm_HandSolder; MPN C0603C104Z3VACTU
R24: 38.3k; R_0201_0603Metric_Pad0.64x0.40mm_HandSolder; MPN ERJ-3EKF3832V
R36: 10k; R_0201_0603Metric_Pad0.64x0.40mm_HandSolder; MPN CRGCQ0603F10K
R37: 2k2; R_0201_0603Metric_Pad0.64x0.40mm_HandSolder; MPN CRGCQ0603F2K2
R38, R39: 22k; R_0201_0603Metric_Pad0.64x0.40mm_HandSolder; MPN CRGCQ0603F22K
U5: DG509BEQ-T1-E3; TSSOP-16_4.4x5mm_P0.65mm; MPN DG509BEQ-T1-E3
U6: CD4071B; SOIC-14_3.9x8.7mm_P1.27mm; MPN CD4071BM96

Connections:
+12V: C23.1, C24.1, R24.1, R37.1, U5.14 (V+), U6.14 (Vdd); also elsewhere on the board
-12V: U5.3 (V-); also elsewhere on the board
/IN1_L: U5.4 (S1A); also elsewhere on the board
/IN1_R: U5.13 (S1B); also elsewhere on the board
/IN2_L: U5.5 (S2A); also elsewhere on the board
/IN2_R: U5.12 (S2B); also elsewhere on the board
/IN3_L: U5.6 (S3A); also elsewhere on the board
/IN3_R: U5.11 (S3B); also elsewhere on the board
/IN4_L: U5.7 (S4A); also elsewhere on the board
/IN4_R: U5.10 (S4B); also elsewhere on the board
/pre_vol_audio_L: U5.8 (DA); also elsewhere on the board
/pre_vol_audio_R: U5.9 (DB); also elsewhere on the board
/source_select/input_sw_1: U6.1 (B); also elsewhere on the board
/source_select/input_sw_2: U6.5 (D); also elsewhere on the board
/source_select/input_sw_3: U6.2 (A), U6.6 (C); also elsewhere on the board
/source_select/input_sw_com: R37.2; also elsewhere on the board
GND: C23.2, C24.2, R36.2, R38.2, R39.2, U5.15 (GND), U6.7 (Vss), U6.8 (F), U6.9 (E), U6.12 (H), U6.13 (G); also elsewhere on the board
unnamed: R24.2, R36.1, U5.2 (EN)
unnamed: R38.1, U5.1 (A0), U6.3 (J)
unnamed: R39.1, U5.16 (A1), U6.4 (K)

Board: 6 copper layers, 191 parts (26 on the bottom side), 114 nets, no tracks yet.
