scadam526/audio_amp_main_board/(commit log)

2020-01-20 Initial commit of working directory.
    [AAMB-B.Cu.gbl, AAMB-B.Mask.gbs, AAMB-B.Paste.gbp, AAMB-B.SilkS.gbo, AAMB-B_Cu.gbl, AAMB-B_Mask.gbs, AAMB-B_Paste.gbp, AAMB-B_SilkS.gbo]
2020-01-20 Began placing volume circuit parts, placed a trim pot for R17 to allow pre-amp level adjustment.
    [volume_ctrl.sch]
2020-01-21 Volume circuit placed and connected. Page titles added.
    [AAMB.sch, audio_pwr_L.sch, audio_pwr_R.sch, protect_mute.sch, volume_ctrl.sch]
2020-01-21 Deleted soft start circuit. Not needed right now.
    [soft_start.sch]
2020-01-21 Deleted obsolete left and right channel schematics.
    [L-channel.sch, R-channel.sch]
2020-01-21 Started input select circuit.
    [AAMB.sch, audio_pwr_L.sch, audio_pwr_R.sch, input_select.sch, protect_mute.sch, volume_ctrl.sch]
2020-01-22 Opened on home office computer. Some rescue and lib conversion happened. Need to confirm no changes on work laptop.
    [AAMB.sch, audio_pwr_L.sch, audio_pwr_R.sch, input_select.sch, protect_mute.sch, volume_ctrl.sch]
2020-01-22 Fixed several DRC errors. Tied audoi input returns to GND. Added Switch logic.
    [AAMB.sch, audio_pwr_L.sch, audio_pwr_R.sch, input_select.sch, protect_mute.sch, volume_ctrl.sch]
2020-01-22 Schecmatic cleanup.
    [AAMB.sch, input_select.sch, protect_mute.sch]
2020-01-23 Added test points. Schematic cleanup.
    [AAMB.sch, audio_pwr_R.sch, input_select.sch, protect_mute.sch, volume_ctrl.sch]
2020-01-23 Cleaning up user configs.
    [AAMB.sch, input_select.sch, protect_mute.sch, volume_ctrl.sch]
2020-01-23 Testing branch. Pulled parts into layout.
    [AAMB.kicad_pcb, AAMB.sch]
2020-01-23 23JAN2020 daily commit.
    [AAMB.kicad_pcb, AAMB.sch, audio_pwr_L.sch, audio_pwr_R.sch]
2020-01-24 Some layout progress. Nightly commit.
    [AAMB.kicad_pcb, AAMB.sch, audio_pwr_L.sch, audio_pwr_R.sch, input_select.sch, protect_mute.sch, volume_ctrl.sch]
2020-01-24 24JAN2020 daily
    [AAMB.kicad_pcb, audio_pwr_L.sch, audio_pwr_R.sch]
2020-01-25 Daily commit and ready to merge back to master.
    [AAMB.kicad_pcb]
2020-01-27 26JAN2020 nightly. Continued placement arangment.
    [AAMB.kicad_pcb]
2020-01-27 Prep to merge.
    [AAMB.kicad_pcb]
2020-01-27 Layout progress
    [AAMB.kicad_pcb, AAMB.sch, audio_pwr_L.sch, audio_pwr_R.sch, input_select.sch, protect_mute.sch, volume_ctrl.sch]
2020-01-27 Just before autoroute. DRC's not addressed.
    [AAMB.kicad_pcb]
2020-01-28 First pass auto-route
    [AAMB.kicad_pcb]
2020-01-28 First pass layout. Needs DRC errors address for next pass.
    [AAMB.kicad_pcb]
2020-01-31 Daily. 4-layer layout done. Only one no-connect.
    [AAMB.kicad_pcb]
2020-01-31 Manual layout started.
    [AAMB.kicad_pcb]
2020-02-02 Linux test and some layout progress.
    [AAMB.kicad_pcb]
2020-02-04 Routing complete. Needs silscreen cleanup and screw holes placed.
    [AAMB.kicad_pcb]
2020-02-04 Added screw holes.
    [AAMB.kicad_pcb]
2020-02-06 Ready to clean up silkscreen. Need to open in windows and make library table references and not direct file pointers.
    [AAMB.kicad_pcb]
2020-02-06 Some silkscreen progress. Windows already setup to use library references. Use config paths in linux to set them up too.
    [AAMB.kicad_pcb]
2020-02-08 Generated fab files for quote test.
    [AAMB-B.Cu.gbl, AAMB-B.Mask.gbs, AAMB-B.Paste.gbp, AAMB-B.SilkS.gbo, AAMB-B_Cu.gbl, AAMB-B_Mask.gbs, AAMB-B_Paste.gbp, AAMB-B_SilkS.gbo]
2020-04-06 Silkscreen cleanup. Rev A release candidate.
    [AAMB.kicad_pcb]
2020-04-09 Lots of part changes to SMD devices. Adding MPN, MFG to all parts for BOM export.
    [AAMB Rev A BOM.xlsx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]
2020-04-10 Layout startover, sorting, some routing. Removed redundant fuses. BOM export.
    [AAMB Rev A BOM.xlsx, AAMB.kicad_pcb, AAMB.sch, audio_pwr_L.sch, audio_pwr_R.sch, input_select.sch, protect_mute.sch, volume_ctrl.sch]
2020-04-11 Layout progress. Added two missing decoupling caps.
    [AAMB.kicad_pcb, volume_ctrl.sch]
2020-04-16 Capturing layout progress.
    [AAMB.kicad_pcb, AAMB.sch, audio_pwr_L.sch, audio_pwr_R.sch]
2020-04-21 Place and route complete. Silkscreen cleanup needed.
    [AAMB Rev A BOM.xlsx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]
2020-04-22 Layout complete. Screw holes added and connected to GND.
    [AAMB Rev A BOM.xlsx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]
2020-04-22 Adding BOM file.
    [AAMB Rev A BOM.xlsx]
2023-02-07 Updating files with Rev02
    [AAMB Rev A BOM.xlsx, AAMB.kicad_pcb, AAMB.kicad_sch, audio_pwr_L.kicad_sch, audio_pwr_R.kicad_sch, input_select.kicad_sch, protect_mute.kicad_sch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]
2023-02-11 Minor layout updates.
    [AAMB.kicad_pcb, audio_pwr_L.kicad_sch, audio_pwr_R.kicad_sch]
2023-03-01 Updating layout and various changes. Backup commit.
    [AAMB.kicad_pcb, AAMB.kicad_sch, audio_pwr_L.kicad_sch, audio_pwr_R.kicad_sch, protect_mute.kicad_sch, source_select.kicad_sch, volume_ctrl.kicad_sch]
